AstronomickaExpedice/CloudChamber/README.md

# CloudChamber
Návrh mlžné komory pro Astronomickou expedici
