AstronomickaExpedice/CloudChamber/doc/img/schema.pdf

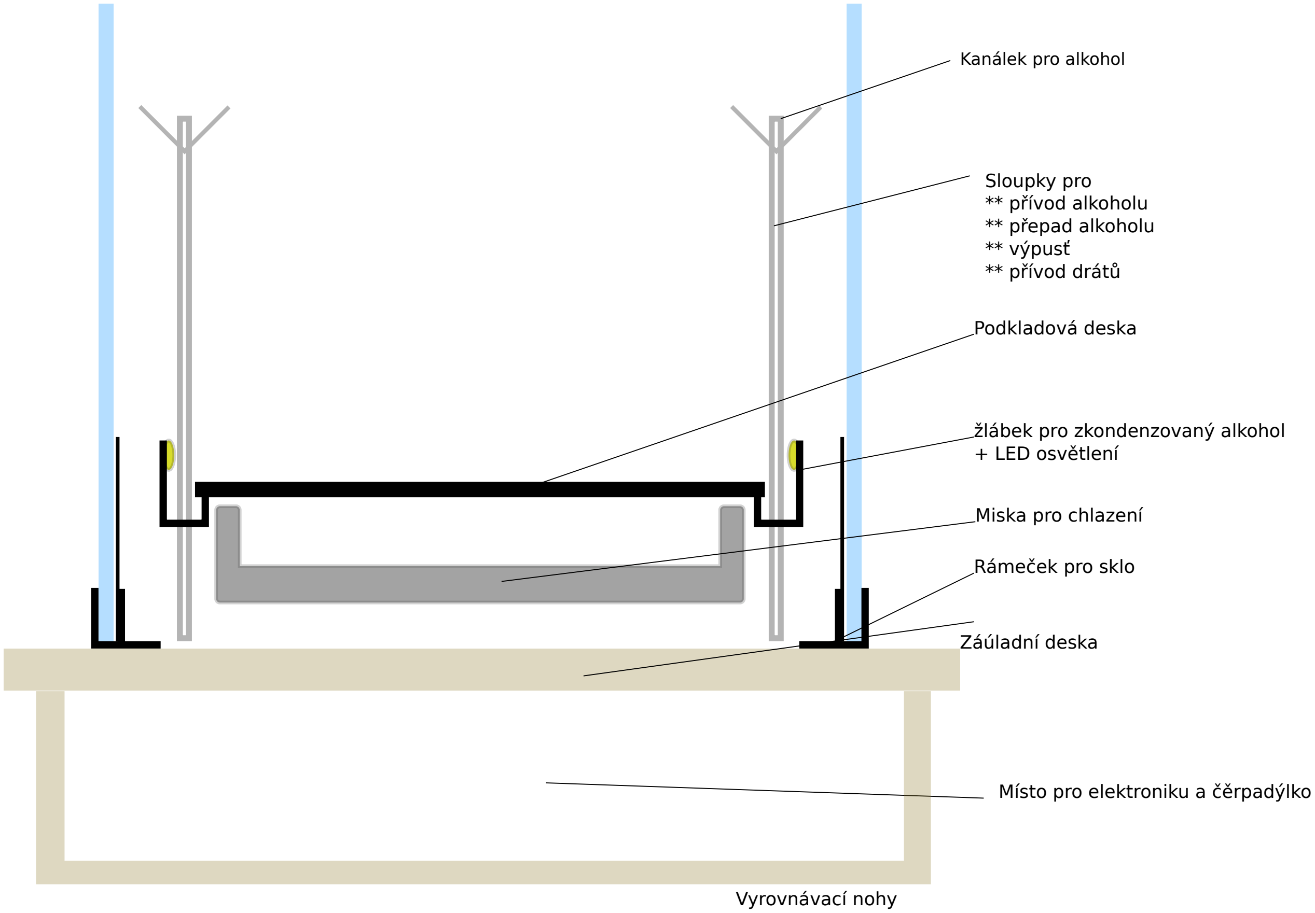
[picture p1: figure]
Kanálek pro alkohol; Sloupky pro ** přívod alkoholu ** přepad alkoholu ** výpusť ** přívod drátů; Podkladová deska; žlábek pro zkondenzovaný alkohol + LED osvětlení; Miska pro chlazení; Rámeček pro sklo; Záúladní deska; Místo pro elektroniku a čěrpadýlko; Vyrovnávací nohy
