AstronomickaExpedice/CloudChamber/doc/img/schema.svg.png

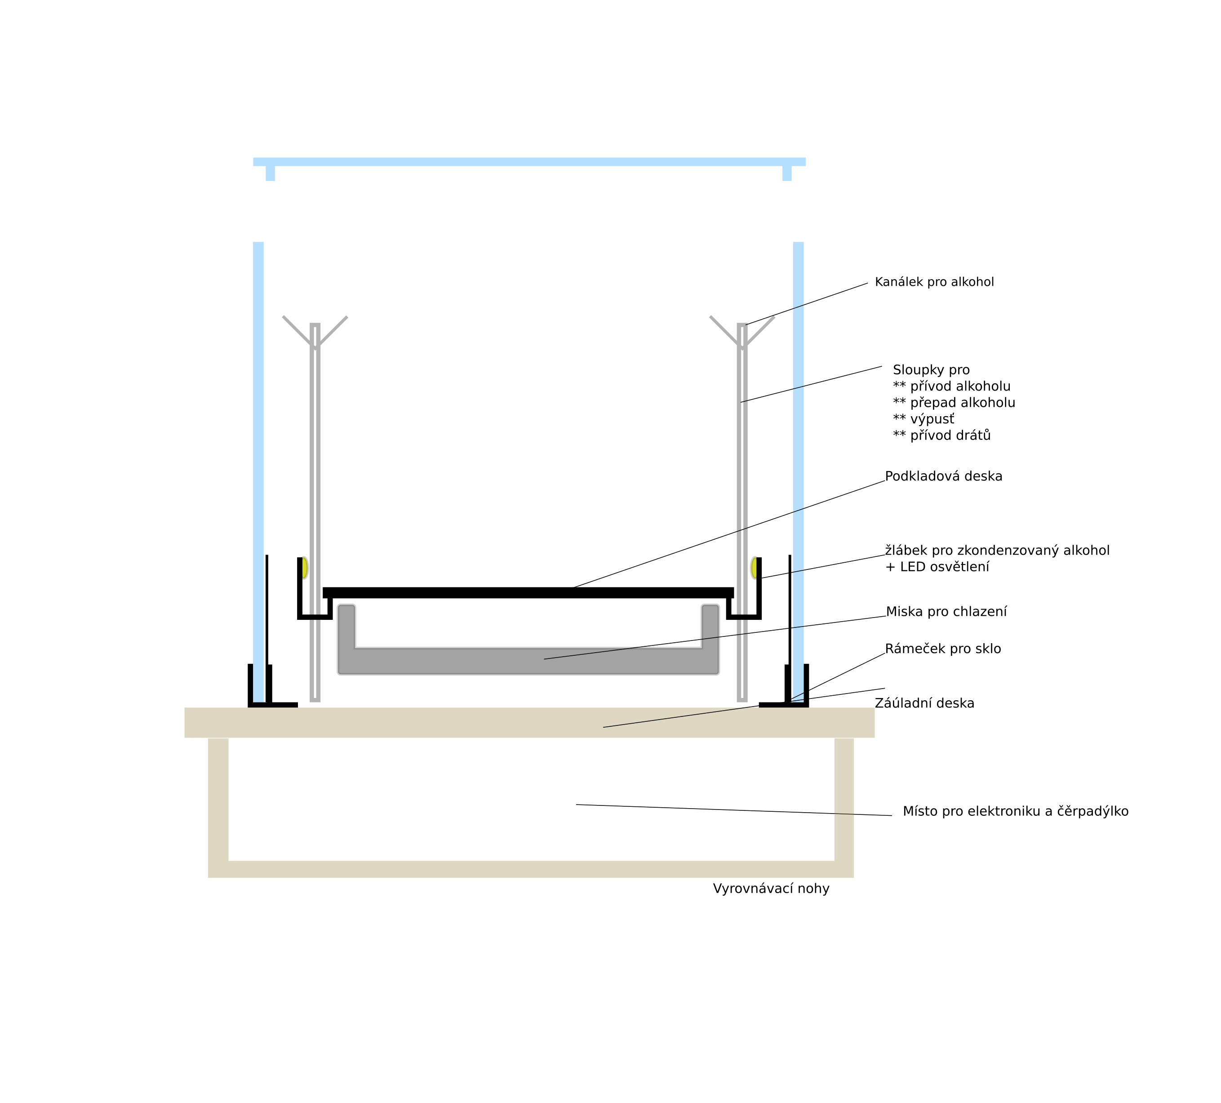
doc/img/schema.svg.png
