AstronomickaExpedice/CloudChamber/cad/CloudChamber_peltier.fcstd

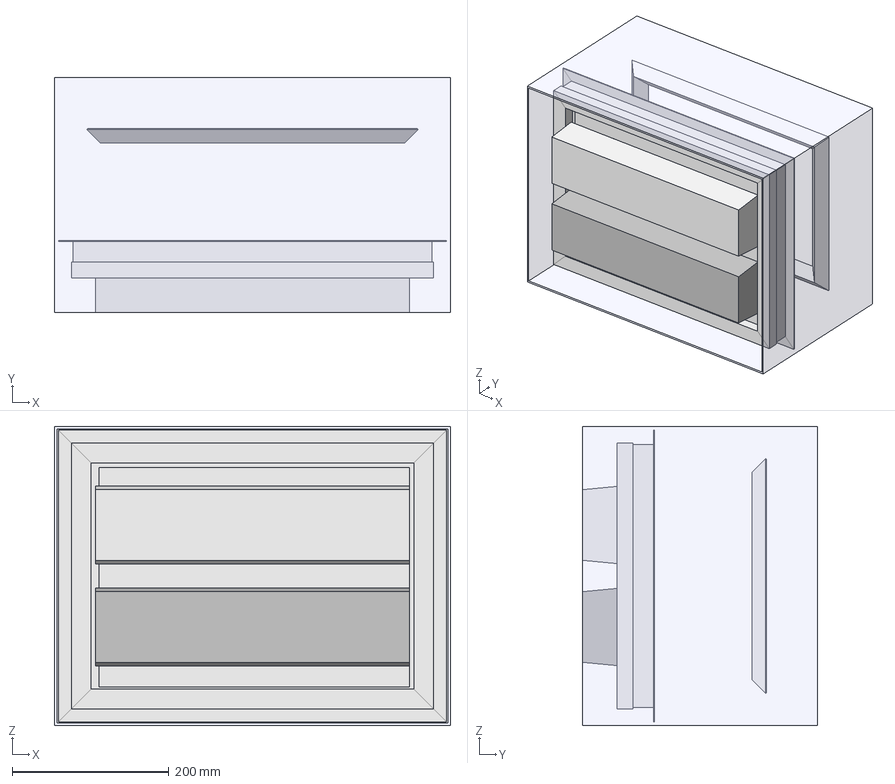
[picture p3: CAD file, 2018-12-21]
cad/CloudChamber_peltier.fcstd
504.7 x 300.0 x 381.3 mm
Chladící podložka
Chladic
Chladici podlozka - mezistupeň
stěny
drzak_led
