AstronomickaExpedice/CloudChamber/cad/CloudChamber_01.fcstd

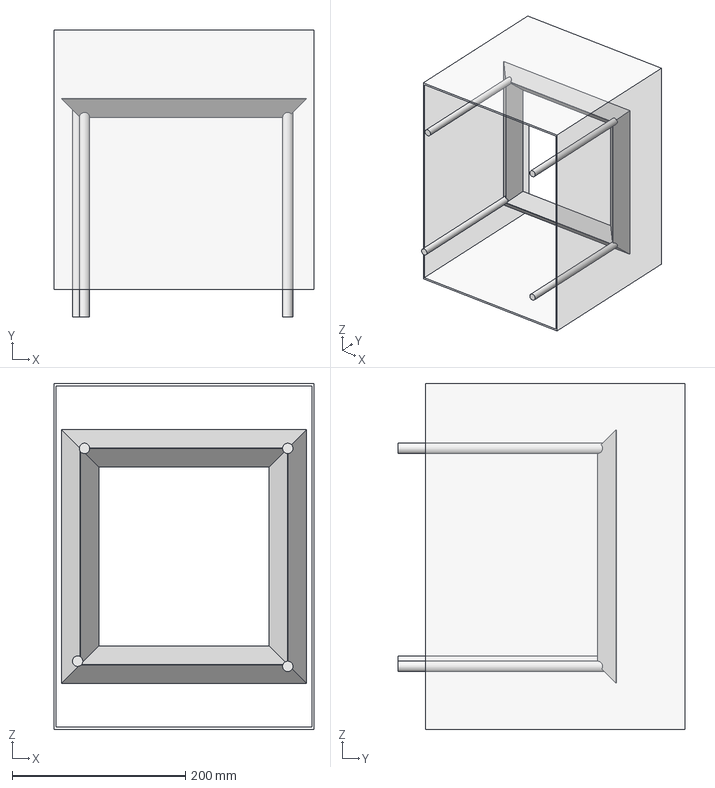
[picture p4: CAD file, 2018-04-11]
cad/CloudChamber_01.fcstd
300.0 x 332.0 x 400.0 mm
Válec
